KuhlTime/Navitron-Hardware/Navitron.pdf

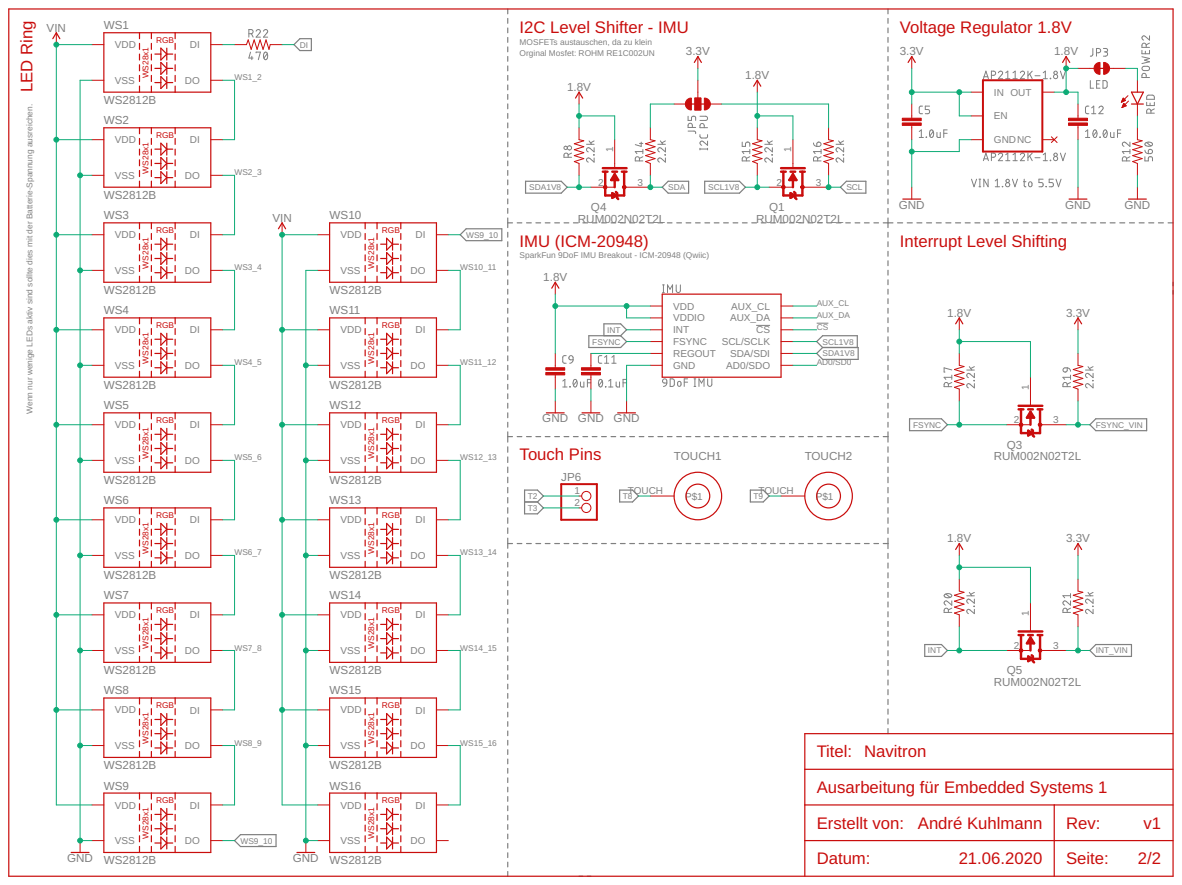
[picture p1: page 1]

MOSFETs austauschen, da zu klein
Orginal Mosfet: ROHM RE1C002UN

Wenn nur wenige LEDs aktiv sind sollte dies mit der Batterie-Spannung ausreichen.

SparkFun 9DoF IMU Breakout - ICM-20948 (Qwiic)

SDA/SDI VDD
VDDIO
INT REGOUT SCL/SCLK
FSYNC GND

Ausarbeitung für Embedded Systems 1

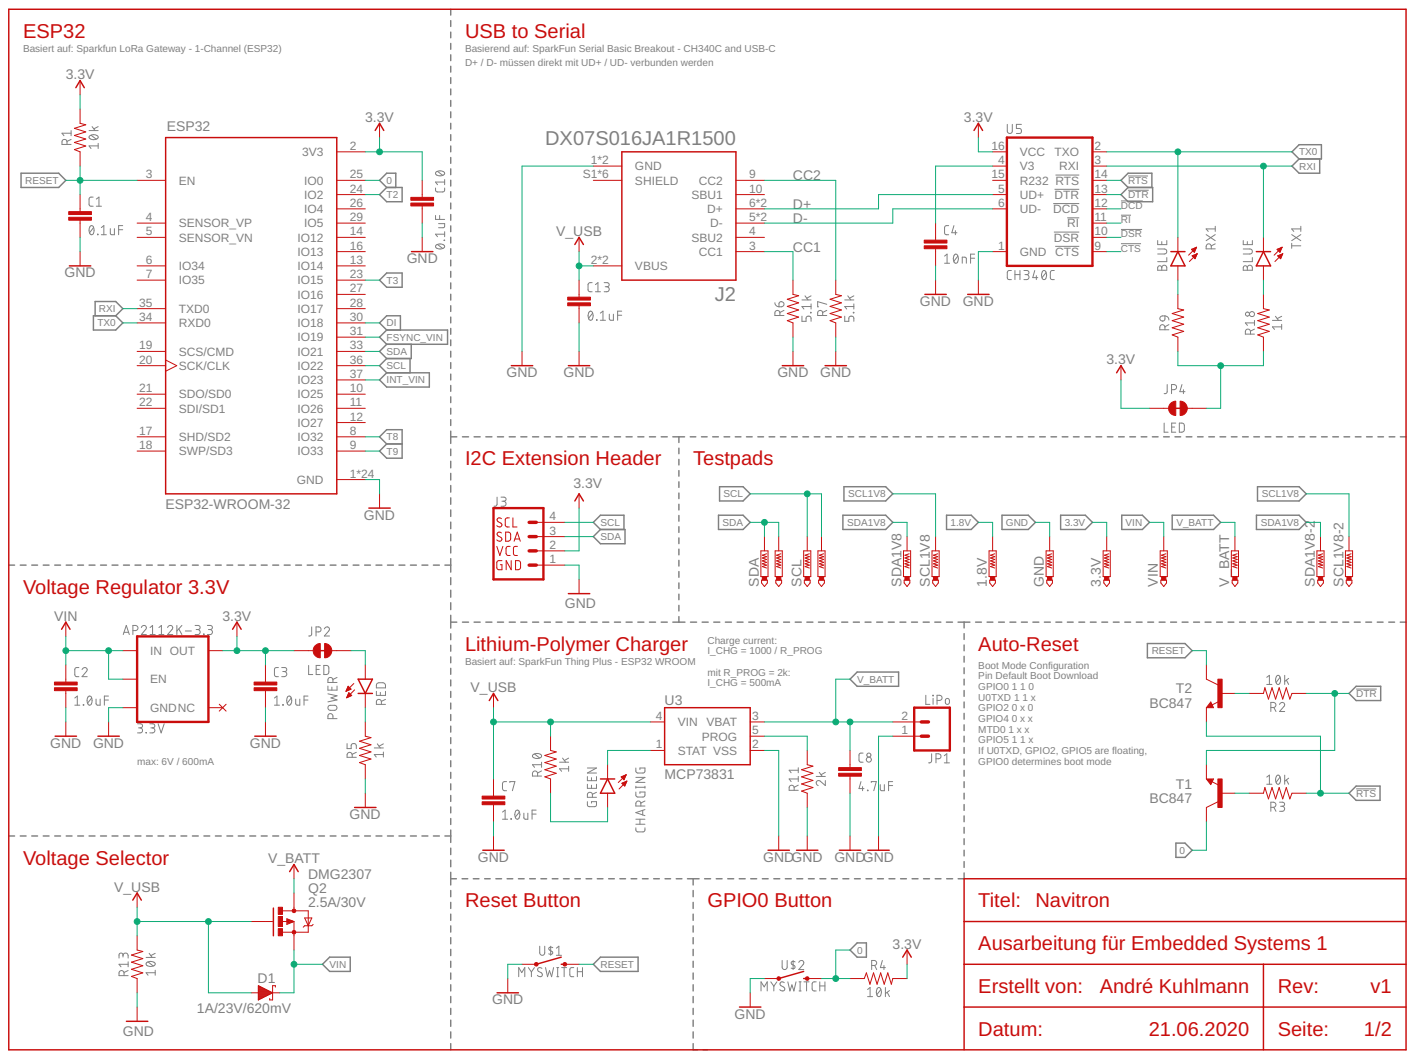
[picture p2: page 2]

Basiert auf: Sparkfun LoRa Gateway - 1-Channel (ESP32)

D+ / D- müssen direkt mit UD+ / UD- verbunden werden Basierend auf: SparkFun Serial Basic Breakout - CH340C and USB-C

Basiert auf: SparkFun Thing Plus - ESP32 WROOM
V_USB

Boot Mode Configuration Pin Default Boot Download GPIO0 1 1 0 U0TXD 1 1 x GPIO2 0 x 0 GPIO4 0 x x MTD0 1 x x GPIO5 1 1 x

If U0TXD, GPIO2, GPIO5 are floating, GPIO0 determines boot mode

Ausarbeitung für Embedded Systems 1

Erstellt von: André Kuhlmann | Rev: v1

Datum: 21.06.2020 | Seite: 1/2
