KuhlTime/Navitron-Hardware/Navitron.brd

## EAGLE design Navitron.brd (2020-07-30)

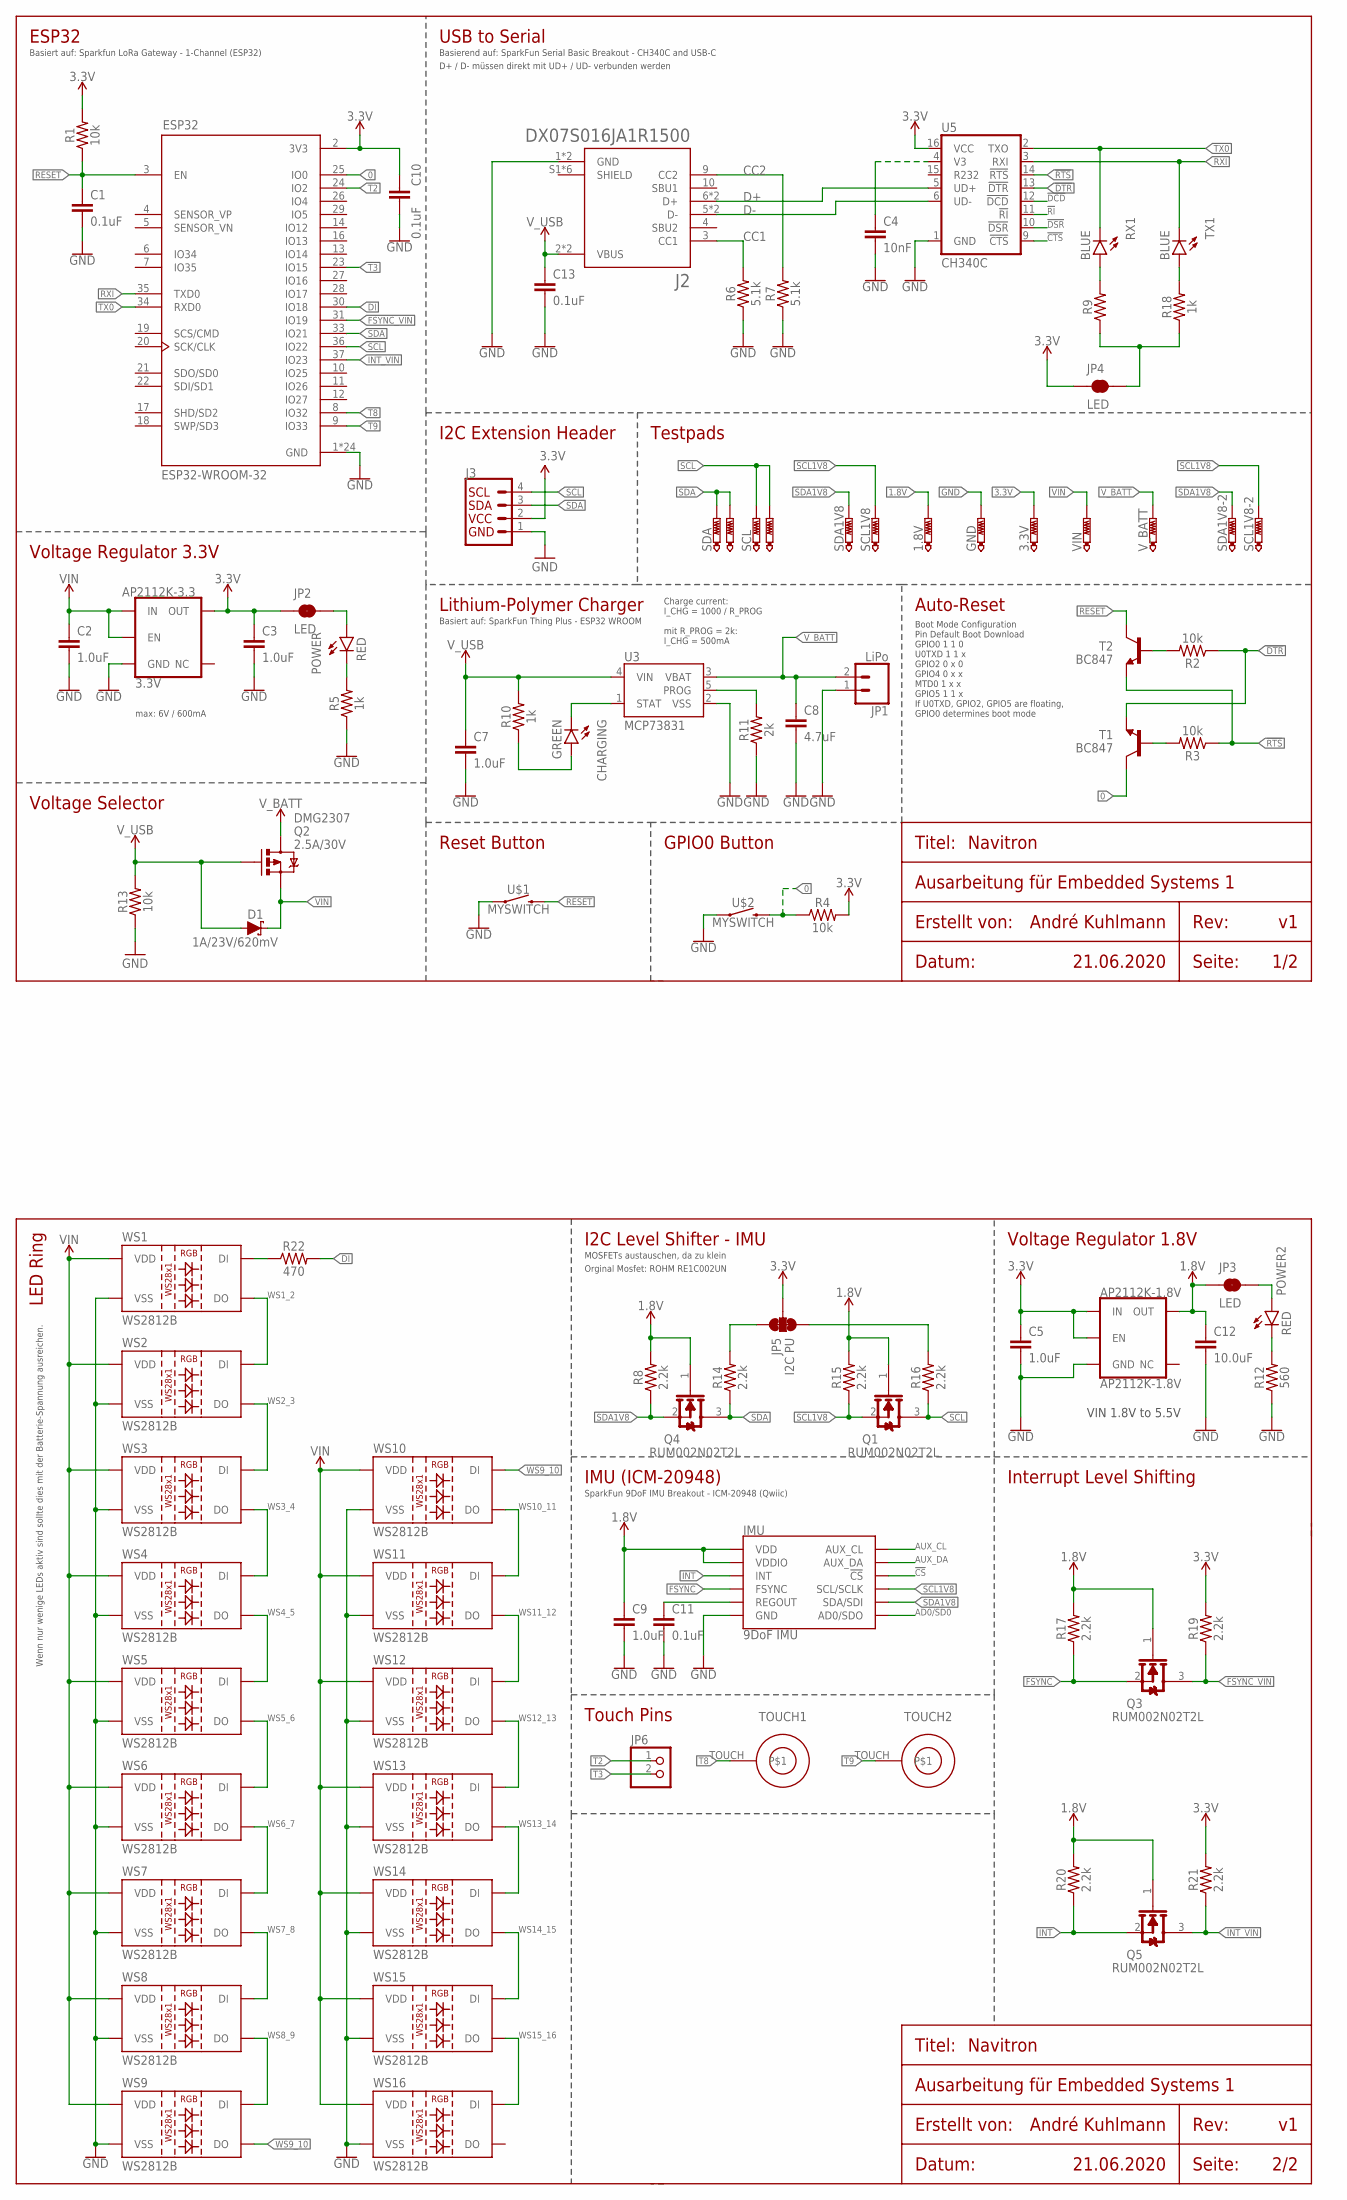
[picture p3: schematic Navitron.sch]

Parts:
1.8V, 3.3V: PTR1B1,27; B1,27
AP2112K-1.8V: AP2112K-1.8V; SOT23-5
AP2112K-3.3: 3.3V; SOT23-5
C1, C10, C11, C13: 0.1uF; 0603
C2, C3, C5, C7, C9: 1.0uF; 0603
C4: 10nF; 0603
C8: 4.7uF; 0603
C12: 10.0uF; 0603
CHARGING: GREEN; LED-0603
D1: 1A/23V/620mV; SOD-323
ESP32: ESP32-WROOM-32; MODULE_ESP32-WROOM-32
GND: PTR1B1,27; B1,27
IMU: 9DoF IMU; QFN24-3X3-ICM-20948
J2: DX07S016JA1R1500; JAE_DX07S016JA1R1500
J3: QWIIC_CONNECTORJS-1MM; 1X04_1MM_RA
JP1: LiPo; JST-2-SMD
JP2, JP3, JP4: LED; SMT-JUMPER_2_NC_TRACE_SILK
JP5: I2C PU; SMT-JUMPER_3_2-NC_TRACE_SILK
JP6: PINHD-1X2; 1X02
POWER, POWER2: RED; LED-0603
Q1, Q3, Q4, Q5: ROHM_RUM002N02T2LROHM_RUM002N02T2L_0_0; ROHM_RUM002N02T2L_0
Q2: 2.5A/30V; SOT23-3@1
R1, R2, R3, R4, R13: 10k; 0603
R5, R10, R18: 1k; 0603
R6, R7: 5.1k; 0603
R8, R14, R15, R16, R17, R19, R20, R21: 2.2k; 0603
R9: 10MOHM-0603-1/10W-5%; 0603
R11: 2k; 0603
R12: 560; 0603
R22: 470; 0603
RX1: BLUE; LED-0603
SCL, SCL1, SCL1V8, SCL1V8-2: PTR1B1,27; B1,27
SDA, SDA1, SDA1V8, SDA1V8-2: PTR1B1,27; B1,27
T1, T2: BC847; SOT23
TOUCH1, TOUCH2: TOUCHPAD8MM; TOUCHPAD-8MM
TX1: BLUE; LED-0603
U3: MCP73831; SOT23-5
U5: CH340C; SO016
U$1, U$2: MYSWITCH; MY-BUTTON
VIN: PTR1B1,27; B1,27
V_BATT: PTR1B1,27; B1,27
WS1, WS2, WS3, WS4, WS5, WS6, WS7, WS8, WS9, WS10, WS11, WS12, WS13, WS14, WS15, WS16: WS2812B

Connections:
0: ESP32.25 (IO0), R4.1, T1.3 (C), U$2.P$2 (2)
1.8V: 1.8V.TP, AP2112K-1.8V.5 (OUT), C9.1, C12.1, IMU.8 (VDDIO), IMU.13 (VDD), JP3.1, Q1.1 (GATE), Q3.1 (GATE), Q4.1 (GATE), Q5.1 (GATE), R8.2, R15.2, R17.2, R20.2
3.3V: 3.3V.TP, AP2112K-1.8V.1 (IN), AP2112K-1.8V.3 (EN), AP2112K-3.3.5 (OUT), C3.1, C5.1, C10.1, ESP32.2 (3V3), J3.2, JP2.1, JP4.1, JP5.2, R1.2, R4.2, R19.2, R21.2, U5.16 (VCC)
!CS: IMU.22 (!CS)
!CTS: U5.9 (!CTS)
!DCD: U5.12 (!DCD)
!DSR: U5.10 (!DSR)
!DTR: R2.1, T1.2 (E), U5.13 (!DTR)
!RI: U5.11 (!RI)
!RTS: R3.1, T2.2 (E), U5.14 (!RTS)
AD0/SD0: IMU.9 (AD0/SDO)
AUX_CL: IMU.7 (AUX_CL)
AUX_DA: IMU.21 (AUX_DA)
CC1: J2.3 (CC1), R6.2
CC2: J2.9 (CC2), R7.2
CHAR_LED_VIN: CHARGING.A, R10.1
D+: J2.6 (D+), J2.7 (D+), U5.5 (UD+)
D-: J2.5 (D-), J2.8 (D-), U5.6 (UD-)
DI: ESP32.30 (IO18), R22.2
DI_TO_WS: R22.1, WS1.4 (DI)
FSYNC: IMU.11 (FSYNC), Q3.2 (SOURCE), R17.1
FSYNC_VIN: ESP32.31 (IO19), Q3.3 (DRAIN), R19.1
GND: AP2112K-1.8V.2 (GND), AP2112K-3.3.2 (GND), C1.2, C2.2, C3.2, C4.2, C5.2, C7.2, C8.2, C9.2, C10.2, C11.2, C12.2, C13.2, ESP32.1 (GND), ESP32.15 (GND), ESP32.38 (GND), ESP32.39_1 (GND), ESP32.39_2 (GND), ESP32.39_3 (GND), ESP32.39_4 (GND), ESP32.39_5 (GND), ESP32.39_6 (GND), ESP32.39_7 (GND), ESP32.39_8 (GND), ESP32.39_9 (GND), ESP32.39_10 (GND), ESP32.39_11 (GND), ESP32.39_12 (GND), ESP32.39_13 (GND), ESP32.39_14 (GND), ESP32.39_15 (GND), ESP32.39_16 (GND), ESP32.39_17 (GND), ESP32.39_18 (GND), ESP32.39_19 (GND), ESP32.39_20 (GND), ESP32.39_21 (GND), GND.TP, IMU.18 (GND), IMU.20 (GND), J2.1 (GND), J2.12 (GND), J3.1, JP1.1 (2), R5.1, R6.1, R7.1, R11.1, R12.1, R13.1, U3.2 (VSS), U5.1 (GND), U$1.P$1 (1), U$2.P$1 (1), WS1.3 (VSS), WS2.3 (VSS), WS3.3 (VSS), WS4.3 (VSS), WS5.3 (VSS), WS6.3 (VSS), WS7.3 (VSS), WS8.3 (VSS), WS9.3 (VSS), WS10.3 (VSS), WS11.3 (VSS), WS12.3 (VSS), WS13.3 (VSS), WS14.3 (VSS), WS15.3 (VSS), WS16.3 (VSS)
INT: IMU.12 (INT), Q5.2 (SOURCE), R20.1
INT_VIN: ESP32.37 (IO23), Q5.3 (DRAIN), R21.1
LED1.8: JP3.2, POWER2.A
LED1.8_2: POWER2.C, R12.2
unnamed: POWER.C, R5.2
unnamed: JP2.2, POWER.A
PROG: R11.2, U3.5 (PROG)
REGOUT: C11.1, IMU.10 (REGOUT)
RESET: C1.1, ESP32.3 (EN), R1.1, T2.3 (C), U$1.P$2 (2)
RXI: ESP32.35 (TXD0), TX1.C, U5.3 (RXI)
SCL: ESP32.36 (IO22), J3.4, Q1.3 (DRAIN), R16.1, SCL.TP, SCL1.TP
SCL1V8: IMU.23 (SCL/SCLK), Q1.2 (SOURCE), R15.1, SCL1V8.TP, SCL1V8-2.TP
SDA: ESP32.33 (IO21), J3.3, Q4.3 (DRAIN), R14.1, SDA.TP, SDA1.TP
SDA1V8: IMU.24 (SDA/SDI), Q4.2 (SOURCE), R8.1, SDA1V8.TP, SDA1V8-2.TP
SDA_W_1: JP5.1, R14.2
SDA_W_2: JP5.3, R16.2
STAT: CHARGING.C, U3.1 (STAT)
T2: ESP32.24 (IO2), JP6.1
T3: ESP32.23 (IO15), JP6.2
T8: ESP32.8 (IO32), TOUCH1.TOUCH
T9: ESP32.9 (IO33), TOUCH2.TOUCH
TO_RX_LED: R18.2, TX1.A
TO_T1: R3.2, T1.1 (B)
TO_T2: R2.2, T2.1 (B)
TO_TX_LED: R9.2, RX1.A
TX0: ESP32.34 (RXD0), RX1.C, U5.2 (TXO)
TX_RX_LED_SUPPLY: JP4.2, R9.1, R18.1
V3_CH340: C4.1, U5.4 (V3)
VIN: AP2112K-3.3.1 (IN), AP2112K-3.3.3 (EN), C2.1, D1.C, Q2.2 (S), VIN.TP, WS1.1 (VDD), WS2.1 (VDD), WS3.1 (VDD), WS4.1 (VDD), WS5.1 (VDD), WS6.1 (VDD), WS7.1 (VDD), WS8.1 (VDD), WS9.1 (VDD), WS10.1 (VDD), WS11.1 (VDD), WS12.1 (VDD), WS13.1 (VDD), WS14.1 (VDD), WS15.1 (VDD), WS16.1 (VDD)
V_BATT: C8.1, JP1.2 (1), Q2.3 (D), U3.3 (VBAT), V_BATT.TP
V_USB: C7.1, C13.1, D1.A, J2.2 (VBUS), J2.11 (VBUS), Q2.1 (G), R10.2, R13.2, U3.4 (VIN)
WS1_2: WS1.2 (DO), WS2.4 (DI)
WS2_3: WS2.2 (DO), WS3.4 (DI)
WS3_4: WS3.2 (DO), WS4.4 (DI)
WS4_5: WS4.2 (DO), WS5.4 (DI)
WS5_6: WS5.2 (DO), WS6.4 (DI)
WS6_7: WS6.2 (DO), WS7.4 (DI)
WS7_8: WS7.2 (DO), WS8.4 (DI)
WS8_9: WS8.2 (DO), WS9.4 (DI)
WS9_10: WS9.2 (DO), WS10.4 (DI)
WS10_11: WS10.2 (DO), WS11.4 (DI)
WS11_12: WS11.2 (DO), WS12.4 (DI)
WS12_13: WS12.2 (DO), WS13.4 (DI)
WS13_14: WS13.2 (DO), WS14.4 (DI)
WS14_15: WS14.2 (DO), WS15.4 (DI)
WS15_16: WS15.2 (DO), WS16.4 (DI)

Notes on the sheet:
Seite:
1/2
Datum:
21.06.2020
Erstellt von:
André Kuhlmann
Rev:
Ausarbeitung für Embedded Systems 1
Navitron
Titel:
Boot Mode Configuration Pin Default Boot Download GPIO0 1 1 0 U0TXD 1 1 x GPIO2 0 x 0 GPIO4 0 x x MTD0 1 x x GPIO5 1 1 x If U0TXD, GPIO2, GPIO5 are floating, GPIO0 determines boot mode
Basiert auf: Sparkfun LoRa Gateway - 1-Channel (ESP32)
Voltage Regulator 3.3V
ESP32
Auto-Reset
USB to Serial
max: 6V / 600mA
D+ / D- müssen direkt mit UD+ / UD- verbunden werden
Basierend auf: SparkFun Serial Basic Breakout - CH340C and USB-C
Reset Button
GPIO0 Button
Voltage Selector
Lithium-Polymer Charger
Basiert auf: SparkFun Thing Plus - ESP32 WROOM
Charge current: I_CHG = 1000 / R_PROG mit R_PROG = 2k: I_CHG = 500mA
I2C Extension Header
VIN 1.8V to 5.5V
Voltage Regulator 1.8V
IMU (ICM-20948)
2/2
LED Ring
I2C Level Shifter - IMU
Wenn nur wenige LEDs aktiv sind sollte dies mit der Batterie-Spannung ausreichen.
MOSFETs austauschen, da zu klein
SparkFun 9DoF IMU Breakout - ICM-20948 (Qwiic)
Orginal Mosfet: ROHM RE1C002UN
Interrupt Level Shifting
Testpads
Touch Pins
DMG2307

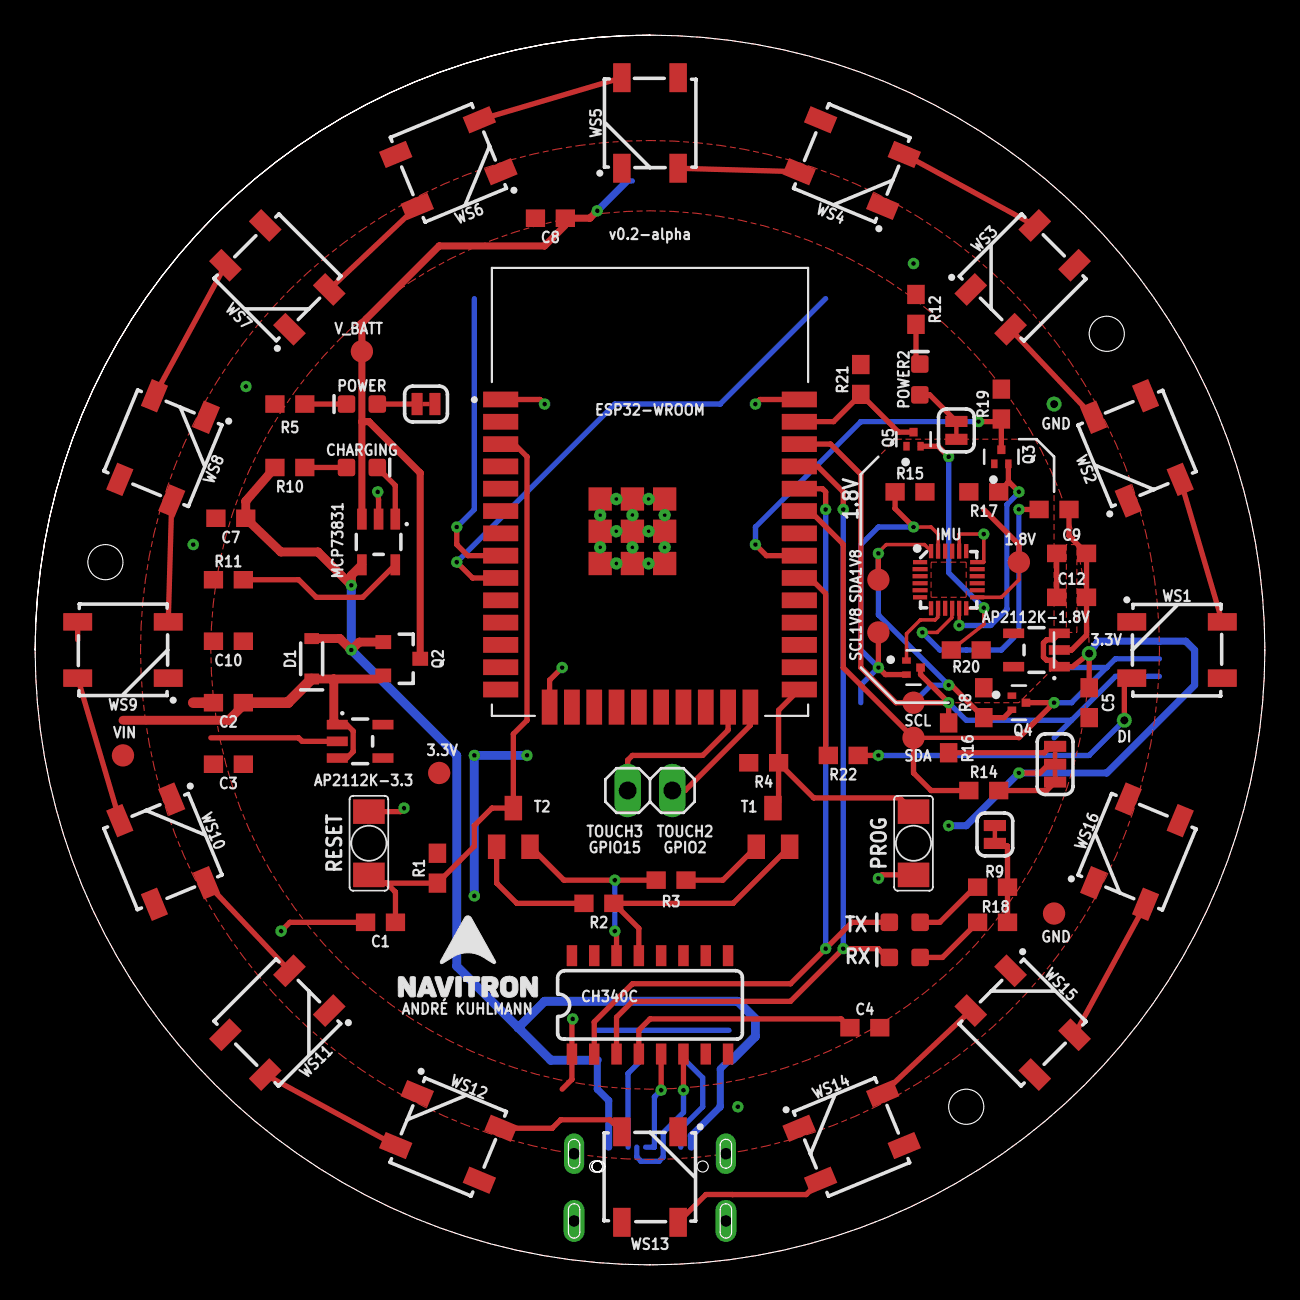
[picture p4: board Navitron.brd from above]

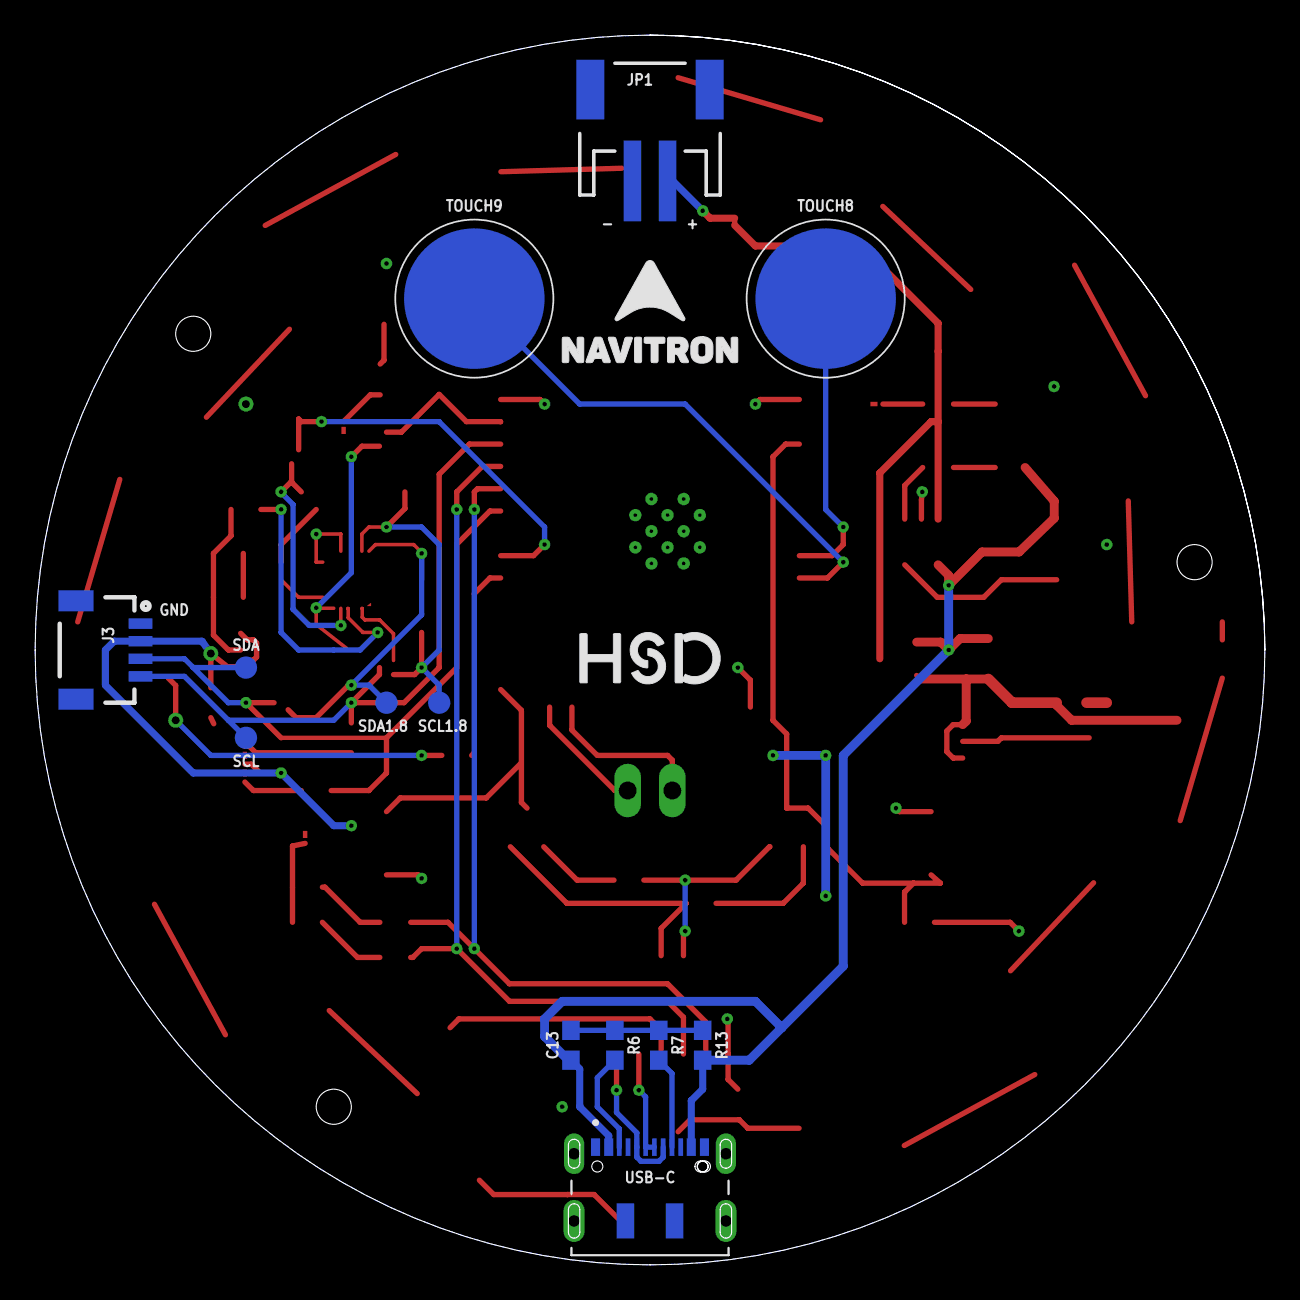
[picture p5: board Navitron.brd from below]

Board: 2 copper layers, 70.0 x 70.0 mm, 94 parts (13 on the bottom side), 61 nets.
