KuhlTime/Navitron-Hardware/(commit log)

2020-07-15 Replace 403 Resistors with 603 Resistors
    [Navitron.sch]
2020-07-19 Pad Renaming
    [Navitron.brd, Navitron.sch]
2020-07-25 Change Voltage Regulator and Resistor Value
    [Navitron.brd, Navitron.sch]
2020-07-25 Change C5 Position
    - Moved Capacitor closer to the 1.8V Voltage Regulator.
    [Navitron.brd]
2020-07-25 Add Testingpoints
    Added Testingpoints for:
    - GND
    - 3.3V
    - 1.8V
    - SDA
    - SCL
    [Navitron.brd, Navitron.sch]
2020-07-26 fix #1
    - Fixed the heatsink, of the ICM-20948 briding the FSYNC and INT lines
    [Navitron.brd, Navitron.sch]
2020-07-26 Remove Temporary Button
    [Navitron.brd, Navitron.sch]
2020-07-28 Tented Vias + Some Changes
    [Navitron.brd, Navitron.sch]
2020-07-28 Touchpads and Logos
    - Added Touchpads
    - Add Logos
    [Navitron.brd, Navitron.sch]
2020-07-28 Connect Touch Pad 8 & 9 and DRC Check
    [Navitron.brd, Navitron.sch]
2020-07-28 Add Additional 1.8V SDA and SCL Pad
    [Navitron.brd, Navitron.sch]
2020-07-28 Change Bottom Logo Position
    [Navitron.brd]
2020-07-28 Cleanup 3.3V Power Circuit
    [Navitron.brd]
2020-07-30 Small changes
    [Navitron.brd, Navitron.sch]
2020-08-10 Change Revision Number
    [Navitron.sch]
2020-08-10 Add Review Material
